Thorwegian/noaidi-fpga-synth-kicad/docs/esp32s3_hw678_top.jpg

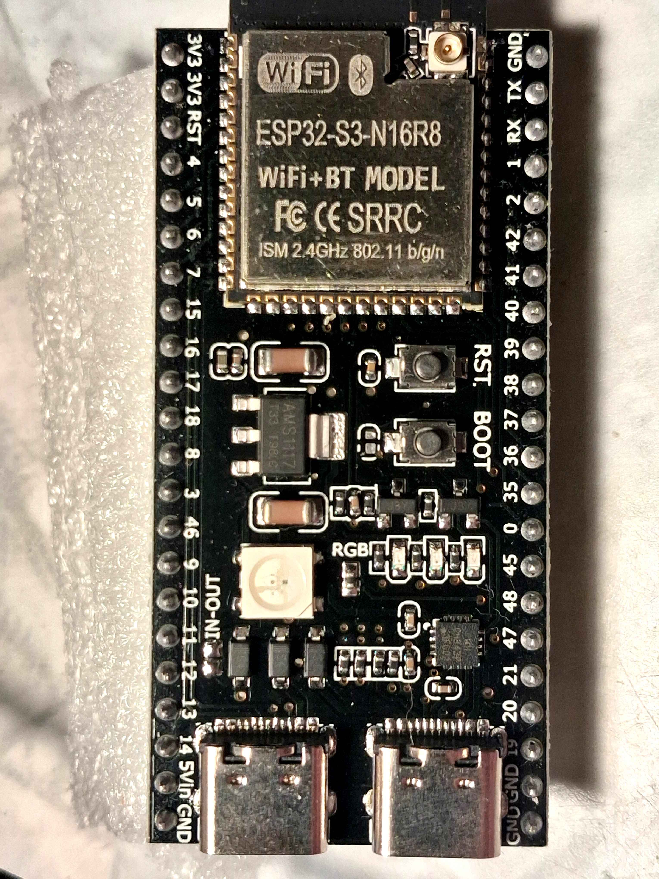
docs/esp32s3_hw678_top.jpg
