Thorwegian/noaidi-fpga-synth-kicad/docs/esp32s3_hw678_bottom.jpg

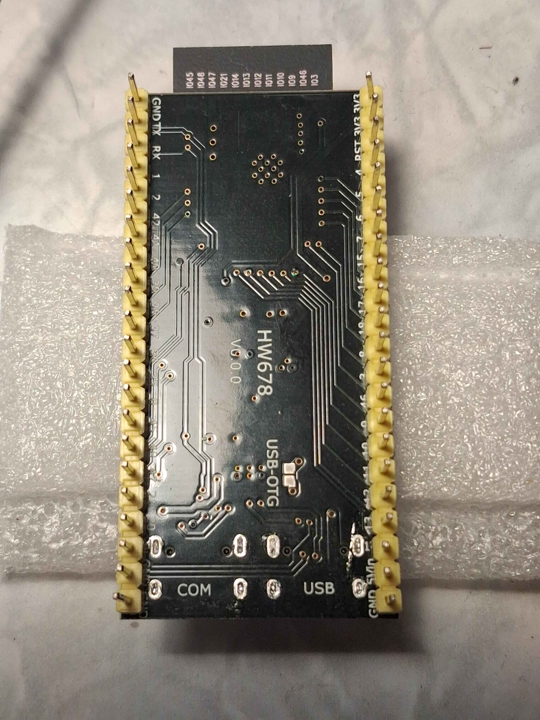
docs/esp32s3_hw678_bottom.jpg
