Thorwegian/noaidi-fpga-synth-kicad/noaidi-fpga-synth.kicad_pcb

## KiCad design noaidi-fpga-synth.kicad_pcb (2026-11-14)

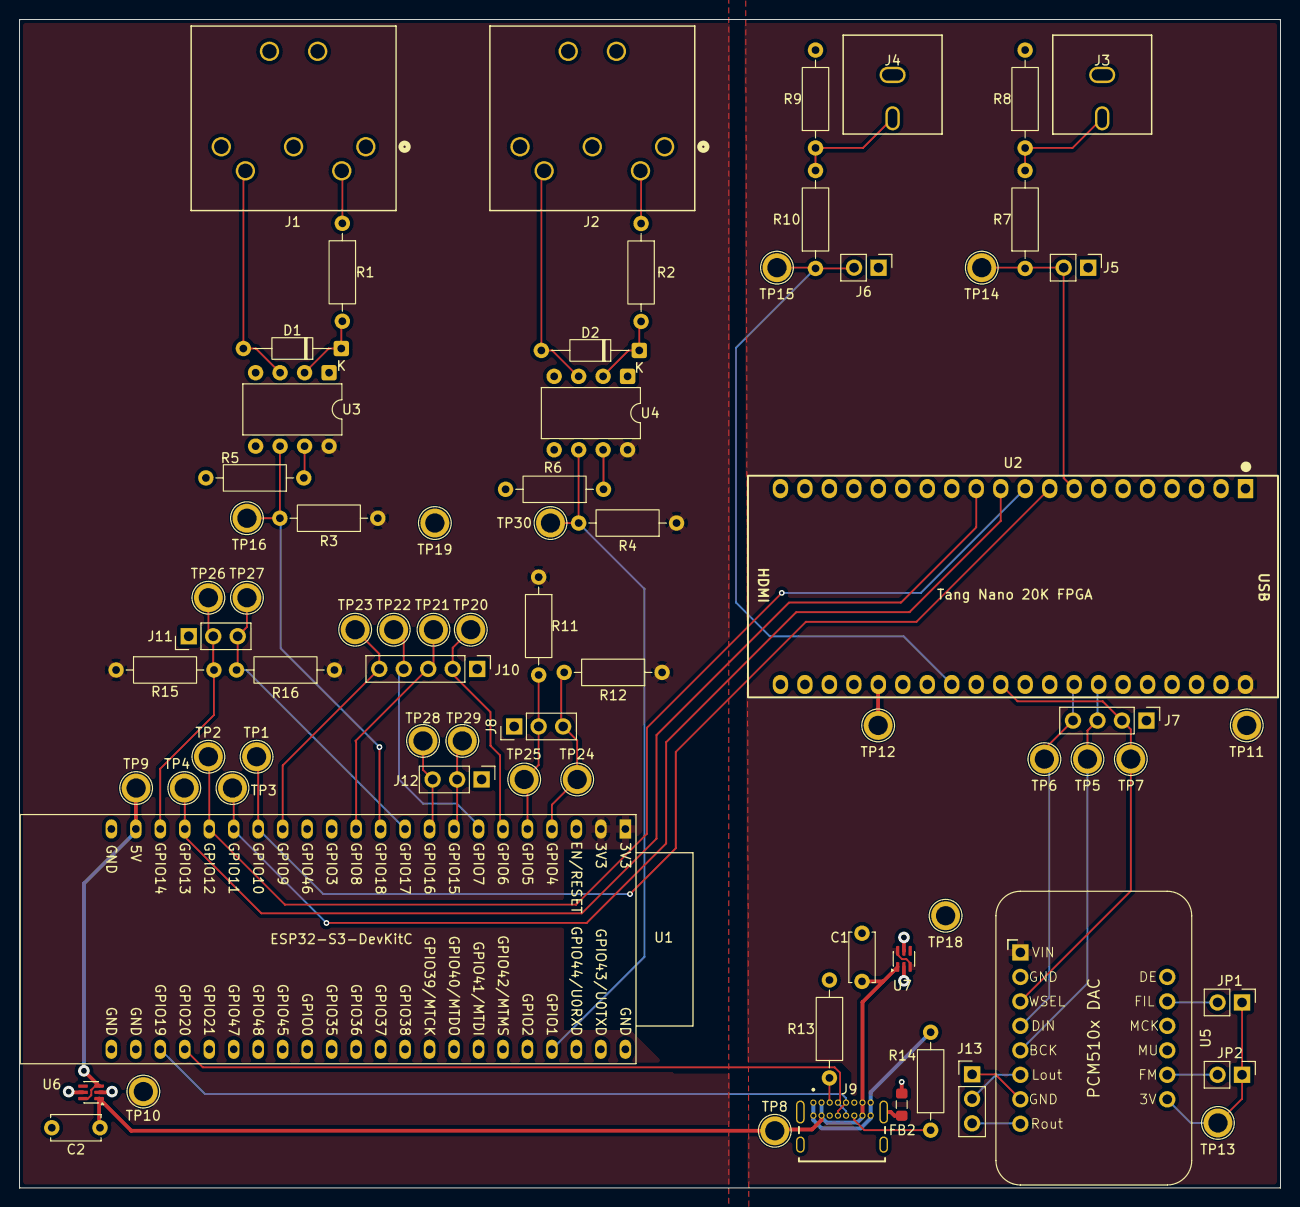
[picture p3: board noaidi-fpga-synth.kicad_pcb from above]

Board: 2 copper layers, 130.8 x 121.2 mm, 72 parts (0 on the bottom side), 48 nets.

Parts:
C1, C2: 1u; C_Disc_D5.0mm_W2.5mm_P5.00mm
D1, D2: D; D_DO-35_SOD27_P10.16mm_Horizontal
FB2: FerriteBead; L_0805_2012Metric_Pad1.05x1.20mm_HandSolder
J1, J2: DIN-5_180degree; Lumberg_0105_05
J3, J4: Conn_Coaxial; RCA_Kycon_KLPX-0848A
J5, J6: Conn_01x02_Pin; PinHeader_1x02_P2.54mm_Vertical
J7: Conn_01x04_Pin; PinHeader_1x04_P2.54mm_Vertical
J8, J11, J12, J13: Conn_01x03_Pin; PinHeader_1x03_P2.54mm_Vertical
J9: USB_C_Receptacle_USB2.0_16P; GCT_USB4085-GF-A_REVB
J10: Conn_01x05_Pin; PinHeader_1x05_P2.54mm_Vertical
JP1, JP2: Jumper_2_Open; PinHeader_1x02_P2.54mm_Vertical
R1, R2, R3, R4, R7, R10: 220; R_Axial_DIN0207_L6.3mm_D2.5mm_P10.16mm_Horizontal
R5, R6, R11, R12, R15, R16: 4.7k; R_Axial_DIN0207_L6.3mm_D2.5mm_P10.16mm_Horizontal
R8, R9: 120; R_Axial_DIN0207_L6.3mm_D2.5mm_P10.16mm_Horizontal
R13, R14: 5.1k; R_Axial_DIN0207_L6.3mm_D2.5mm_P10.16mm_Horizontal
TP1, TP2, TP3, TP4, TP5, TP6, TP7, TP8, TP9, TP10, TP11, TP12, TP13, TP14, TP15, TP16, TP18, TP19, TP20, TP21, TP22, TP23, TP24, TP25, TP26, TP27, TP28, TP29, TP30: TestPoint; TestPoint_Plated_Hole_D2.0mm
U1: ESP32-S3-DevKitC
U2: Tang_Nano_20K; DIP-40_TangNano20K
U3, U4: 6N138; DIP-8_W7.62mm
U5: Adafruit_PCM510x
U6, U7: LM66100DCK; SOT-363_SC-70-6

Connections:
ESP_3V3: R3.1, R4.1, R11.1, R12.1, R15.1, R16.1, TP10.1 (1_1), U1.1 (3V3), U1.2 (3V3), U3.8 (VCC), U4.8 (VCC)
ESP_5V: TP9.1 (1_1), U1.21 (5V), U6.3 (~CE), U6.6 (VOUT)
ESP_UART0_RX: J12.3, TP28.1 (1_1), U1.9 (GPIO16/ADC2_CH5/32K_N)
ESP_UART0_TX: J12.2, TP29.1 (1_1), U1.8 (GPIO15/ADC2_CH4/32K_P)
ESP_UART1_RX: R3.2, TP16.1 (1_1), U1.11 (GPIO18/ADC2_CH7), U3.6 (VO2)
ESP_UART2_RX: R4.2, TP30.1 (1_1), U1.41 (GPIO1/ADC1_CH0), U4.6 (VO2)
EXT_5V: C1.1, C2.1, J9.A4 (VBUS), J9.A9 (VBUS), J9.B4 (VBUS), J9.B9 (VBUS), TP8.1 (1_1), U6.1 (VIN), U7.1 (VIN)
GND: C1.2, C2.2, FB2.2, J3.2 (Ext), J4.2 (Ext), J5.1, J6.1, J7.1, J8.1, J9.A1 (GND), J9.A12 (GND), J9.B1 (GND), J9.B12 (GND), J10.1, J11.1, J12.1, R5.2, R6.2, R8.2, R9.2, R13.2, R14.2, TP18.1 (1_1), TP19.1 (1_1), U1.22 (GND), U1.23 (GND), U1.24 (GND), U1.44 (GND), U2.20 (GND), U2.26 (GND), U2.39 (GND), U3.5 (GND), U4.5 (GND), U5.2 (GND), U6.2 (GND), U6.5 (ST), U7.2 (GND), U7.5 (ST)
I2C0_SCL: J8.3, R12.2, TP24.1 (1_1), U1.4 (GPIO4/ADC1_CH3)
I2C0_SDA: J8.2, R11.2, TP25.1 (1_1), U1.5 (GPIO5/ADC1_CH4)
I2C1_SCL: J11.2, R15.2, TP26.1 (1_1), U1.20 (GPIO14/ADC2_CH3)
I2C1_SDA: J11.3, R16.2, TP27.1 (1_1), U1.10 (GPIO17/ADC2_CH6)
I2S_BCK: J7.3, TP5.1 (1_1), U2.34 (56_IOR36A), U5.5 (BCK)
I2S_DATA: J7.4, TP6.1 (1_1), U2.33 (54_IOR38A), U5.4 (DIN)
I2S_WS: J7.2, TP7.1 (1_1), U2.30 (55_IOR36B), U5.3 (WSEL)
NANO_3V3: TP12.1 (1_1), U2.25 (3V3)
NANO_5V: TP11.1 (1_1), U2.40 (5V), U5.1 (VIN), U7.3 (~CE), U7.6 (VOUT)
unnamed: D1.2 (A), J1.5, U3.3 (C2)
unnamed: D1.1 (K), R1.2, U3.2 (C1)
unnamed: D2.2 (A), J2.5, U4.3 (C2)
unnamed: D2.1 (K), R2.2, U4.2 (C1)
unnamed: FB2.1, J9.S1 (SHIELD), J9.S2 (SHIELD), J9.S3 (SHIELD), J9.S4 (SHIELD)
unnamed: J1.4, R1.1
unnamed: J2.4, R2.1
unnamed: J3.1 (In), R7.2, R8.1
unnamed: J4.1 (In), R9.1, R10.2
unnamed: J9.A5 (CC1), R13.1
unnamed: J9.B5 (CC2), R14.1
unnamed: J13.1, U5.7 (G)
unnamed: J13.2, U5.6 (Lout)
unnamed: J13.3, U5.8 (Rout)
unnamed: JP1.2 (B), U5.13 (FIL)
unnamed: JP2.2 (B), U5.10 (FM)
unnamed: R5.1, U3.7 (VO1)
unnamed: R6.1, U4.7 (VO1)
PCM_3V3: JP1.1 (A), JP2.1 (A), TP13.1 (1_1), U5.9 (3V)
SPDIF0: J5.2, R7.1, TP14.1 (1_1), U2.8 (27_IOB8A)
SPDIF1: J6.2, R10.1, TP15.1 (1_1), U2.28 (86_IOT4A)
SPI2_CS_N: TP1.1 (1_1), U1.16 (GPIO10/ADC1_CH9), U2.9 (28_IOB8B)
SPI2_MISO: TP4.1 (1_1), U1.19 (GPIO13/ADC2_CH2), U2.12 (29_IOB14A)
SPI2_MOSI: TP3.1 (1_1), U1.17 (GPIO11/ADC2_CH0), U2.11 (26_IOB6B)
SPI2_SCLK: TP2.1 (1_1), U1.18 (GPIO12/ADC2_CH1), U2.10 (25_IOB6A)
SPI3_CS_N: J10.2, TP20.1 (1_1), U1.6 (GPIO6/ADC1_CH5)
SPI3_MISO: J10.5, TP23.1 (1_1), U1.15 (GPIO9/ADC1_CH8)
SPI3_MOSI: J10.4, TP22.1 (1_1), U1.7 (GPIO7/ADC1_CH6)
SPI3_SCLK: J10.3, TP21.1 (1_1), U1.12 (GPIO8/ADC1_CH7)
USB_D+: J9.A6 (D+), J9.B6 (D+), U1.26 (GPIO20/USB_D+)
USB_D-: J9.A7 (D-), J9.B7 (D-), U1.25 (GPIO19/USB_D-)
