Thorwegian/noaidi-fpga-synth-kicad/(commit log)

2026-09-16 Initial commit.
    [esp32.kicad_sch, noaidi-fpga-synth.kicad_pcb, noaidi-fpga-synth.kicad_sch, tang_nano_20k.kicad_sch]
2026-09-16 Add extra SPDIF out plus pin header taps for SPDIF and I2S
    [tang_nano_20k.kicad_sch]
2026-09-20 Switched to global net labels, reorganised header connectors.
    [esp32.kicad_sch, tang_nano_20k.kicad_sch]
2026-09-20 Fixed power nets.
    [esp32.kicad_sch, tang_nano_20k.kicad_sch]
2026-09-20 Fixed bad footprints.
    [esp32.kicad_sch, tang_nano_20k.kicad_sch]
2026-09-20 Changed page numbers.
    [esp32.kicad_sch, tang_nano_20k.kicad_sch]
2026-09-20 Added information about DIN/RCA connectors
    [esp32.kicad_sch, tang_nano_20k.kicad_sch]
2026-09-20 New official footprints for DIN/RCA
    [esp32.kicad_sch, tang_nano_20k.kicad_sch]
2026-09-20 Added LM66100 ideal diodes for power source switching.
    [esp32.kicad_sch, tang_nano_20k.kicad_sch]
2026-09-20 Added USB port.
    [esp32.kicad_sch, tang_nano_20k.kicad_sch, usb.kicad_sch]
2026-09-20 Committing project.
    [usb.kicad_sch]
2026-09-20 Test pads sheet.
    [test_points.kicad_sch]
2026-09-20 Various changes.
    [esp32.kicad_sch, tang_nano_20k.kicad_sch, usb.kicad_sch]
2026-09-20 Fixing more ERC warnings.
    [esp32.kicad_sch, tang_nano_20k.kicad_sch, usb.kicad_sch]
2026-09-21 Added pin headers for SPI3, I2C0 and I2C1
    [esp32.kicad_sch, tang_nano_20k.kicad_sch, test_points.kicad_sch, usb.kicad_sch]
2026-09-21 Added I2C pull-ups
    [esp32.kicad_sch]
2026-09-21 Moved UART0 header to new ESP32-S3 pins.
    [esp32.kicad_sch]
2026-09-21 Correcting ERC errors
    [esp32.kicad_sch, tang_nano_20k.kicad_sch, usb.kicad_sch]
2026-09-21 Added jumpers for FM and FIL to DAC. Added pin headers for audio out to DAC. Minor adjustments.
    [esp32.kicad_sch, tang_nano_20k.kicad_sch, test_points.kicad_sch, usb.kicad_sch]
2026-09-21 Added footprints for DAC jumpers.
    [tang_nano_20k.kicad_sch]
2026-09-21 All parts now have footprints.
    [noaidi-fpga-synth.kicad_pcb, tang_nano_20k.kicad_sch, test_points.kicad_sch]
2026-09-21 Completely routed PCB
    [noaidi-fpga-synth.kicad_pcb, tang_nano_20k.kicad_sch, test_points.kicad_sch]
2026-09-24 PCB fixes
    [noaidi-fpga-synth.kicad_pcb]
2026-11-07 README with the board's pictures, and render.sh to regenerate them
    The README had the title and the licence. It now opens with the
    perfboard prototype the board is based on (the PCB is in progress),
    links the gateware/firmware repository and the website, lists what is
    on the board from the schematic, and shows an isometric and a top 3D
    render, the front and back copper plots and a link to the schematic
    PDF. The images are hosted at https://thj.no/synth/images/ and linked
    by URL, so no binaries enter the repository; render.sh regenerates them
    into build/ (gitignored) with kicad-cli from KiCad 10.
2026-11-07 render.sh: pan the isometric camera so the whole board is in frame
    The bottom-left corner was cut off and the top had air; --pan 0.8,-0.8,0 centres it. The hosted pcb-iso.jpg is this output.
2026-11-07 render.sh: centre the isometric render
    Measured on the render itself: the board's bounding box has even margins at zoom 0.85, pan -0.9,1.47. The earlier pan was tuned on a render without --floor, which frames differently.
2026-11-07 crop.py: trim the 3D renders to the board plus an even margin
    render.sh runs it on both renders; the hosted pcb-iso.jpg and pcb-top.jpg are its output (60 px margin).
2026-11-07 README: the 3D render as the hero, the prototype photo under What is on it
2026-11-14 docs/thirdparty: the vendors' mechanical and electrical documents for the board
    The dimension drawings, the 3D model and the data sheets the schematic
    and the layout are drawn from lived in the synth repository
    (Thorwegian/noaidi-fpga-synth, docs/thirdparty at d48b90f), away from
    the KiCad project that uses them.
    Mechanical, moved here (removed from the synth repository in its own
    pull request): the Tang Nano 20K's dimension drawing (.pdf, .dxf) and
    3D model (.step), the Adafruit PCM510x's fab print.
    Electrical, copied (the synth repository keeps its own): the Tang Nano
    20K's schematic and pinout, the GW2AR data sheet, the ESP32-S3-DevKitC-1
    user guide and pinouts, the Adafruit PCM510x gui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
2026-11-14 docs/thirdparty: data sheets for the board's own parts
    Fetched from the links in the schematic's Datasheet fields, so the
    documents are the ones the symbols name: the LM66100 ideal diode (TI
    SLVSEZ8A), the 6N138 optocoupler (onsemi HCPL2731-D), the Lumberg 0105
    DIN socket, the Kycon KLPX RCA socket and the GCT USB4085 USB-C
    receptacle, plus GCT's product drawing with the recommended PCB layout.
    README: the folder's entry names them with their reference designators.
2026-11-14 Tang Nano 20K symbol: pin 13 is chip pin 30, IOB14B
    The symbol named pin 12 `29_IOB14A` and pin 13 `30_IOB14A`, so two
    pins claimed IOB14A. Sipeed's pinout (docs/thirdparty in the documents
    pull request, tang-nano-20k-pinout.png) labels chip pin 29 IOB14A and
    chip pin 30 IOB14B.
    The name changes in the symbol library, in the copy of the symbol
    cached in tang_nano_20k.kicad_sch, and in the board, where the pad
    carries the pin's name and the unconnected pin's generated net name.
    Pin 13 is unconnected, so no net changes.
2026-11-14 S/PDIF dividers: 220 Ω in series, 120 Ω to ground
    R7 and R10 go from 330 Ω to 220 Ω, R8 and R9 from 91 Ω to 120 Ω.
    The old pair was what was on hand for the prototype; 91 Ω has no part
    in JLCPCB's basic library, and into a 75 Ω receiver the pair gave
    0.37 V, under the nominal 0.5 to 0.6 V output level.
    From a 3.3 V pin the new pair gives 0.57 V into 75 Ω from a 78 Ω
    source, and draws 12.4 mA from the pin while it is high.
    Values only, in the sheet and on the board's footprints: no net, no
    footprint and no track changes.
2026-11-14 docs/requirements.md: what the base board has to do
    The requirements as agreed with Thor in the chat on 2026-11-14: the
    instrument the board belongs to (a desktop console unit, this board at
    the bottom of the enclosure, a front panel board later), the eight
    things the board must do with their connectors, how it is made, what
    is not required of it, and three open points (no supply pin on the
    front panel's headers, the current from FPGA pin 86 with the lab jig's
    LED and a receiver together, the fixed positions waiting for the
    enclosure).
    The header assignments are read from the netlists exported per sheet
    with kicad-cli. README: the file's entry under Files.
2026-11-14 docs/requirements.md: the S/PDIF outputs by their use, USB as the MIDI connection, power as its own section
    From Thor's answers in the chat:
    The 96 kHz coaxial output is the listening path into the Focusrite and
    stays. The 48 kHz stream is for the lab's optical capture, an LED on
    the pin header; its coaxial output may not be needed.
    The USB socket is first a USB MIDI class connection to a computer.
    Powering the board from it is wanted if the budget permits. Power gets
    a section: the prototype's two sources, the sources that can coexist
    on the lab jig, the front panel board with a power connector of its
    own, and what is known of the budget.
    Open points follow: power, the USB socket's part,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
2026-11-14 docs/requirements.md: the front panel board is powered from the base board
    Corrects the previous commit, which gave the front panel board a power
    connector of its own. Thor's meaning: the base board has the main
    power connector, separate from the USB socket, and forwards power to
    the front panel board, board to board.
2026-11-14 docs/requirements.md: two USB-C sockets, one for power and one for USB MIDI
    Thor's decision: the existing USB-C path stays as the power input, at
    5 V with its CC resistors and without Power Delivery, and a second
    USB-C socket is added for data. The data socket feeds no rail, so the
    board has one power entry.
    The Power section states this in place of the earlier alternatives,
    with the budget as the current guess. Open: what the board does on a
    weak supply.
2026-11-14 docs/esp32s3_hw678.md: the measurements of the HW-678 ESP32-S3 boards, copied from the synth repository
    The board carries one of these copies of the ESP32-S3-DevKitC-1, and
    the file states what the schematic depends on: the pins the module
    takes for flash and PSRAM, the free pins, the CH343 bridge and the
    native USB port that does not enumerate until its USB-OTG pads are
    bridged.
    Byte-identical to Thorwegian/noaidi-fpga-synth docs/esp32s3_hw678.md
    at b68ddde, which stays where the file is maintained. README: the
    file's entry under Files.
2026-11-14 docs/esp32s3_hw678.md: the header pins, read from a photo of the board
    Thor's photo of the top of one HW-678 board goes in as
    docs/esp32s3_hw678_top.jpg, and the file gains a Header pins section
    read from it:
    - The printed labels are GPIO numbers and their order is the official
    ESP32-S3-DevKitC-1's, position for position, 22 pins a row. The one
    label that differs is 5Vin for 5V.
    - The rows are 25.4 mm apart, not the official board's 22.86 mm:
    10.0 pin steps in the photo (1692 to 1697 px between the rows, 169 px
    between pins), where nine steps would be 1523 px. The footprint U1 is
    Espressif's at 22.86 mm.
    - A pair of IN-OUT solder pads sits beside pins 11 and 12; unmeasured.
    The f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
2026-11-14 HW-678: the underside photo, Espressif's schematic, and no dimension read from a photo
    - docs/esp32s3_hw678_bottom.jpg: Thor's photo of the underside. It
    repeats the pin labels and shows the HW678 V0.0.0 silkscreen, the
    USB-OTG pads and the sockets' names, COM and USB.
    - docs/thirdparty/SCH_ESP32-S3-DevKitC-1_V1.1_20221130.pdf: Espressif's
    schematic of the official board, from dl.espressif.com. The HW-678
    has the official pin order and is taken to work like the official
    board (Thor, 2026-11-14). On the official board each USB socket's
    supply pin reaches VCC_5V, the 5V header pin's net, through a 1N5819
    of its own (D1, D7), so power fed in at the 5V pin cannot reach a
    USB sock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
2026-11-14 docs/esp32s3_hw678.md: show the two photos of the board
    The top and underside photos are embedded side by side under the
    introduction, as the visual reference for the HW-678 (Thor's word).
    They were only named in the text before.
2026-11-14 Move the scripts out of the root folder into scripts/
    The root folder is for the KiCad project, the README and the licence
    (Thor, 2026-11-14). render.sh and crop.py move to scripts/.
    - scripts/render.sh: changes to the repository's root before it runs,
    so it works from any directory and still writes to build/ there; it
    calls scripts/crop.py.
    - README: the Files section states the rule and the new paths.
    - .gitignore: the comment on build/ names the script's new path.
